ncardamone10/ELG4139/Project/topSidePop.png

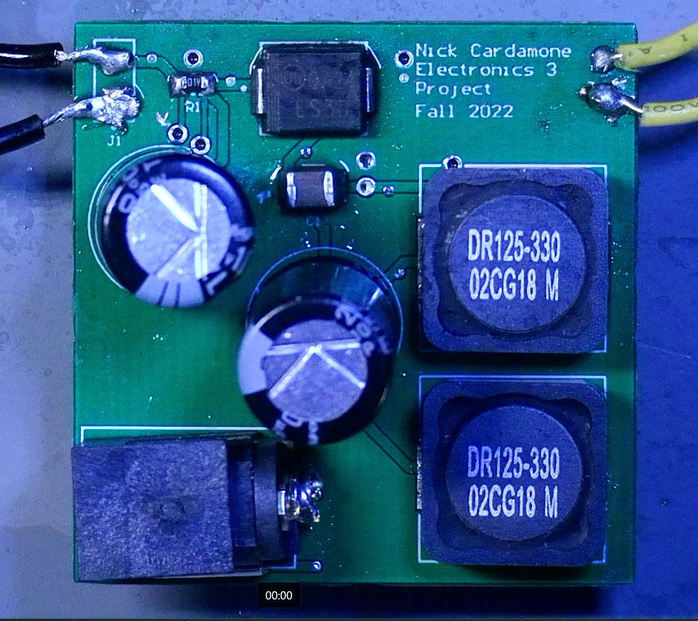
Project/topSidePop.png
