ncardamone10/ELG4139/Project/bottomSidePop.png

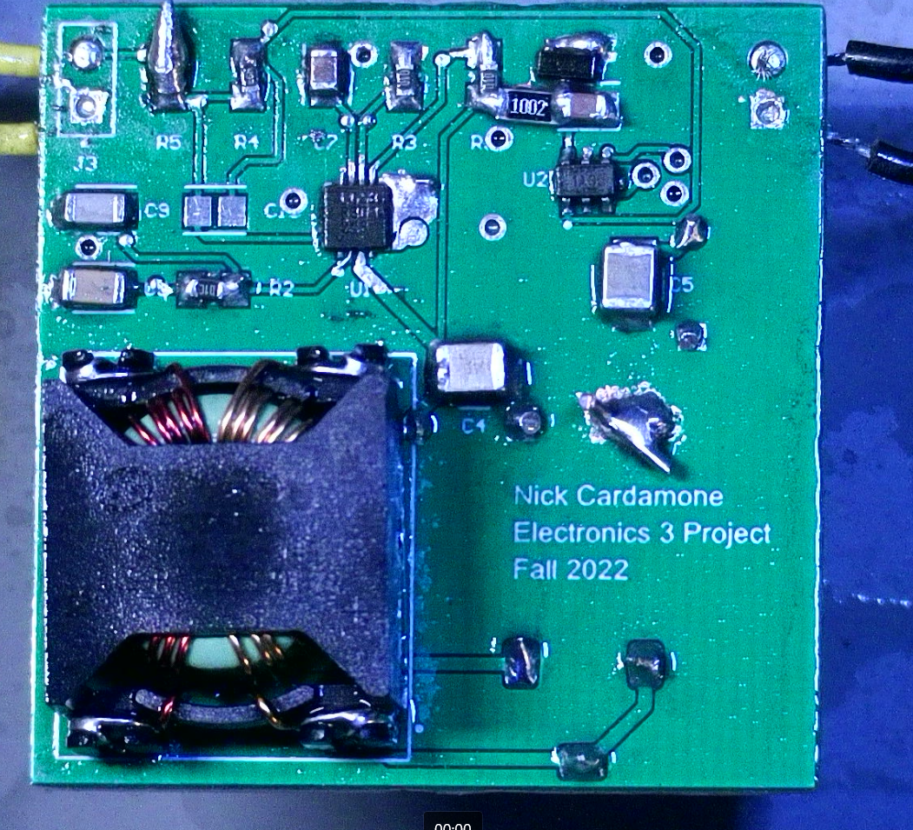
Project/bottomSidePop.png
