ncardamone10/ELG4139/Project/SEPIC Converter Final Lab Pres.pptx

## SEPIC Converter as A Constant Current LED Controller

Nick Cardamone – Electronics 3 – Nov 18 2022

## Background

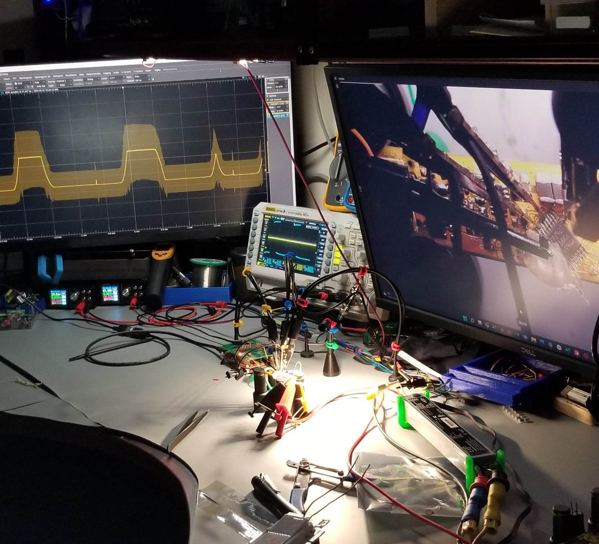
[picture p3: figure]
No description available.

- Did coop terms working at LED lighting company designing LED controllers
- Use scrap light engine for a desk lamp
- Currently use a bench supply to power the light engine

## Hardware Goals

Previous Prototype

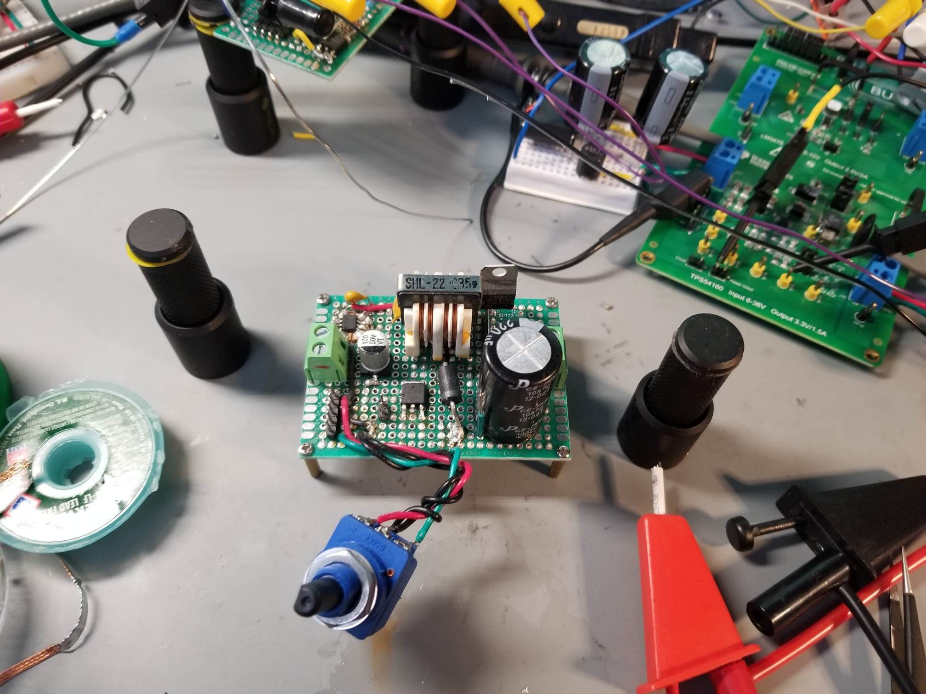
[picture p4: figure]
No description available.
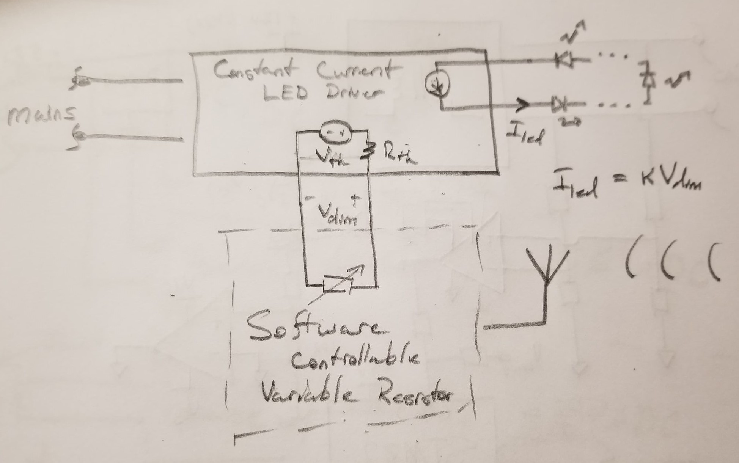
[picture p5: figure]

- I have a need for a contant current power supply (not a channel of a bench supply) to use to power my desk lamp

12V Wall Wart

Pot

No Bluetooth

## Presentation Overview

- Background and Motivation
- Problem Statement and Hardware Goals
- Circuit Diagram
- PCB Layout
- PCB 3D View
- Simulations
- Design Methodology
- Left TODO

## Circuit Diagram

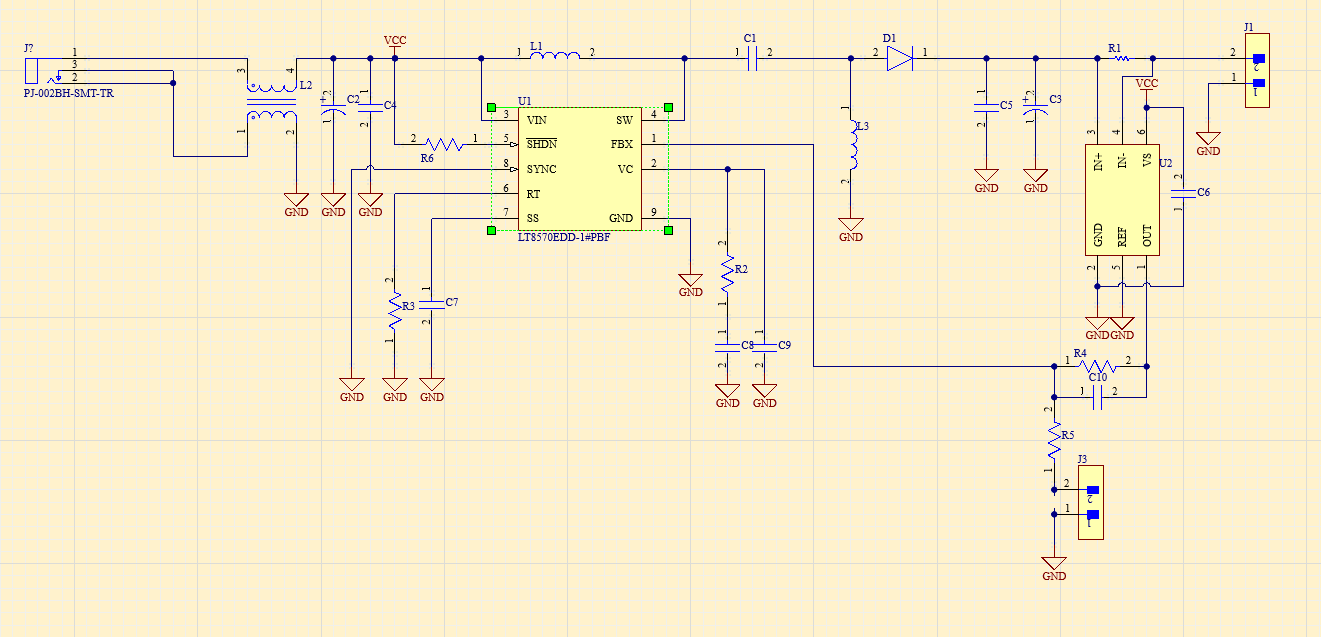
[picture p6: figure]
No description available.

- Sepic converter with current feedback

## Prototype

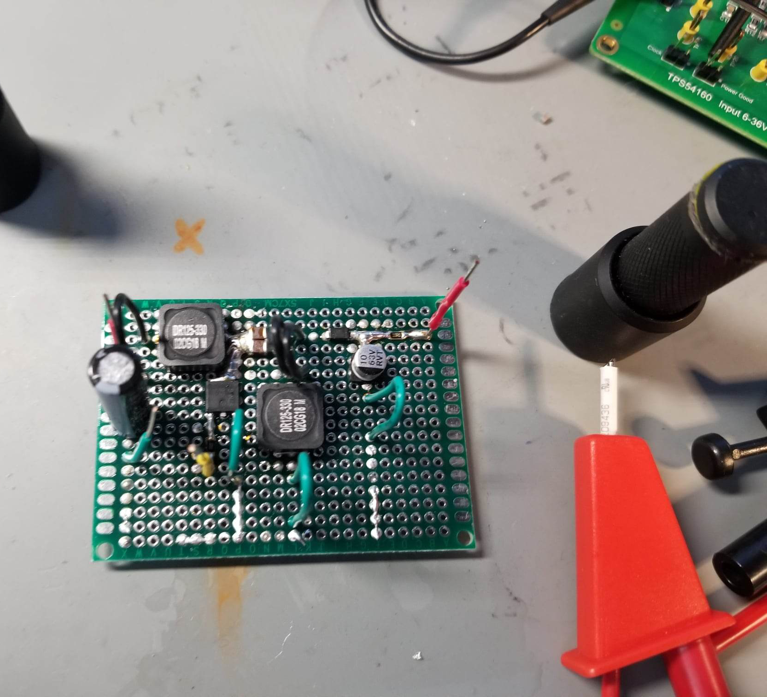
[picture p7: figure]
No description available.

- Open Loop Only

## PCB Layout

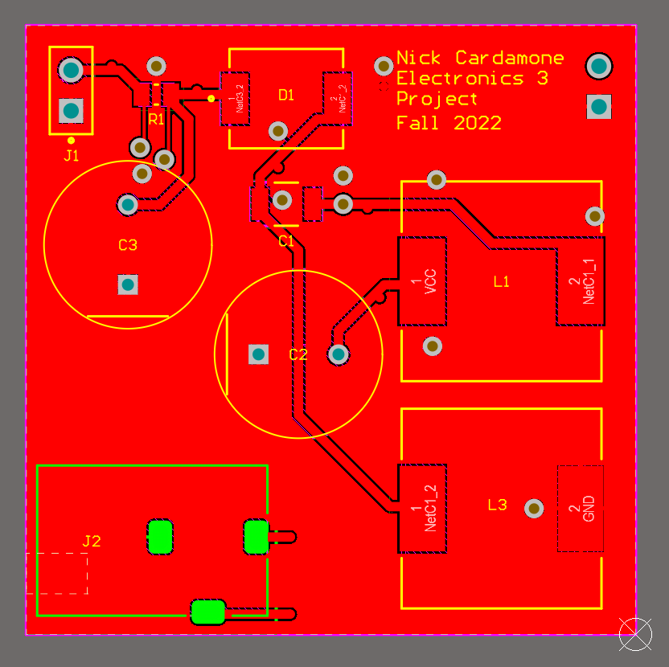
[picture p8: figure]
No description available.
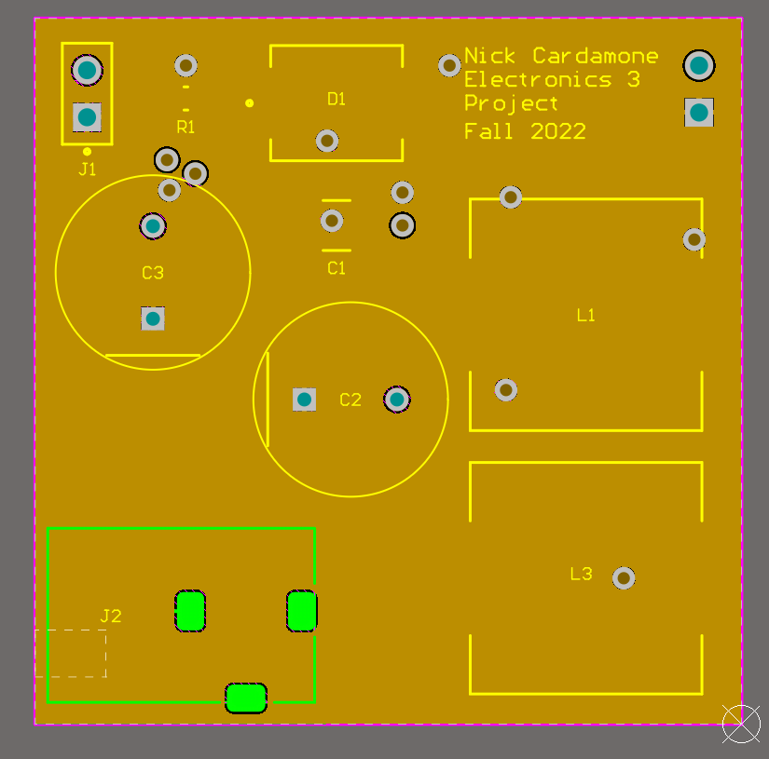
[picture p9: figure]
No description available.
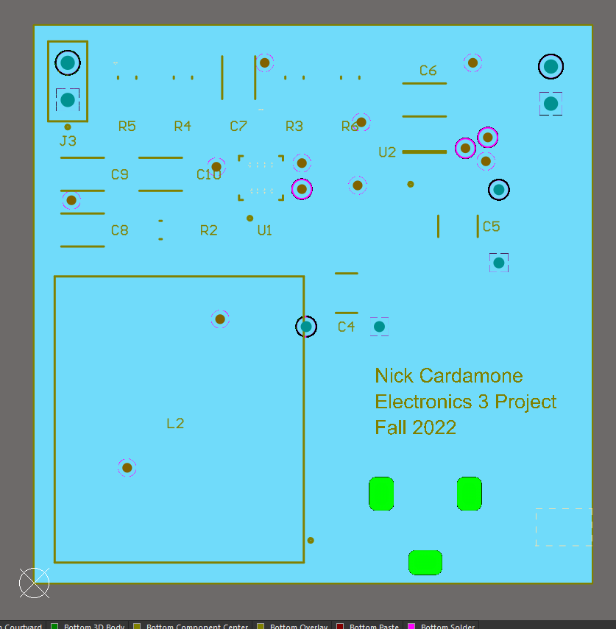
[picture p10: figure]
No description available.
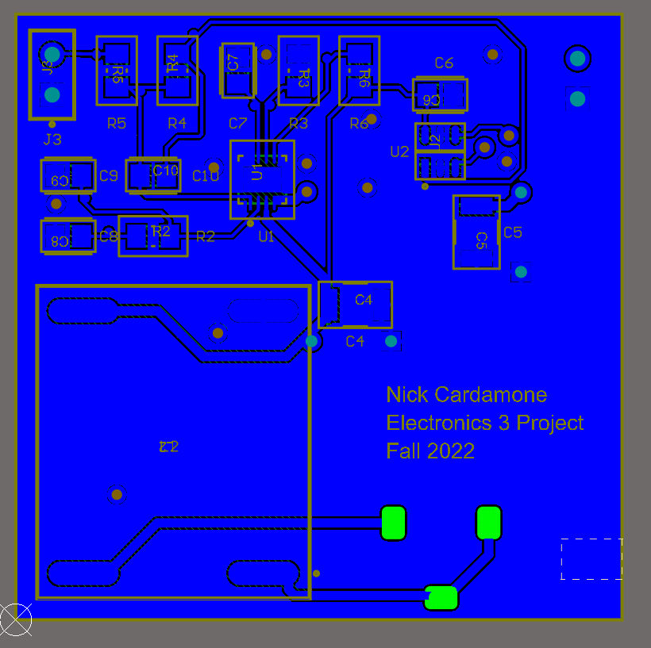
[picture p11: figure]
No description available.

- Layer Stack: Top, Gnd Plane, Gnd Plane, Bottom

## PCB

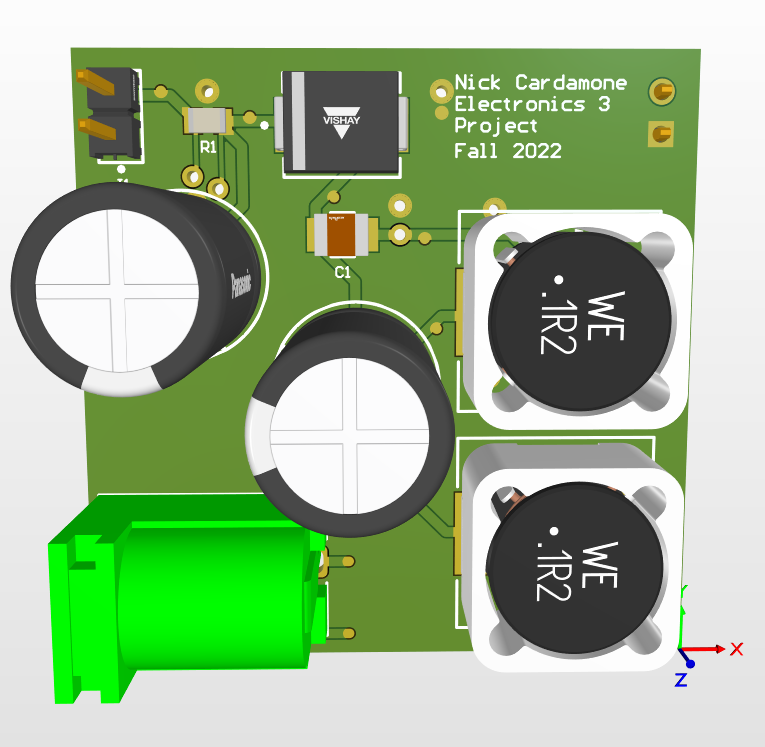
[picture p12: figure]
No description available.
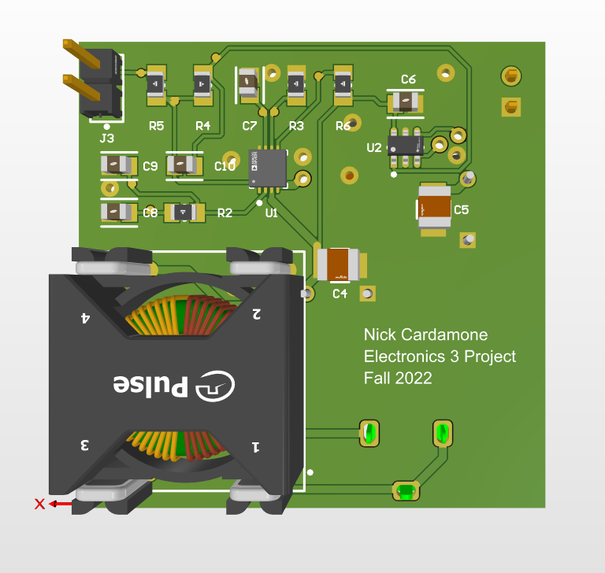
[picture p13: figure]
No description available.
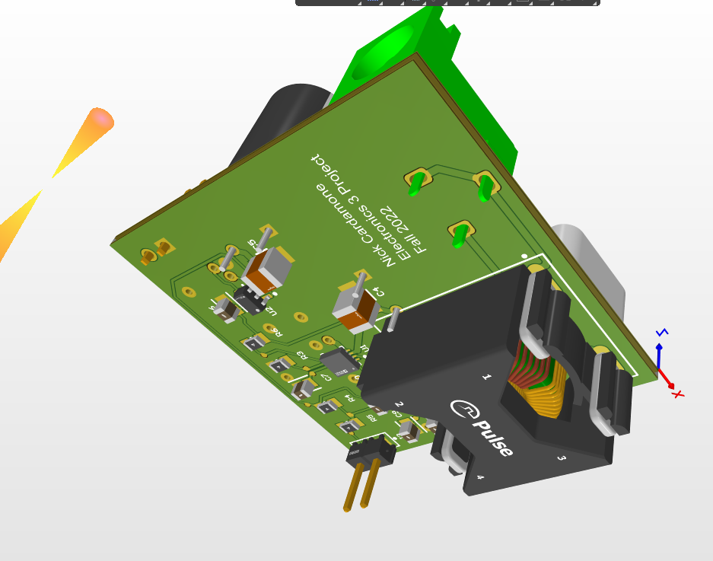
[picture p14: figure]
No description available.

## Simulations

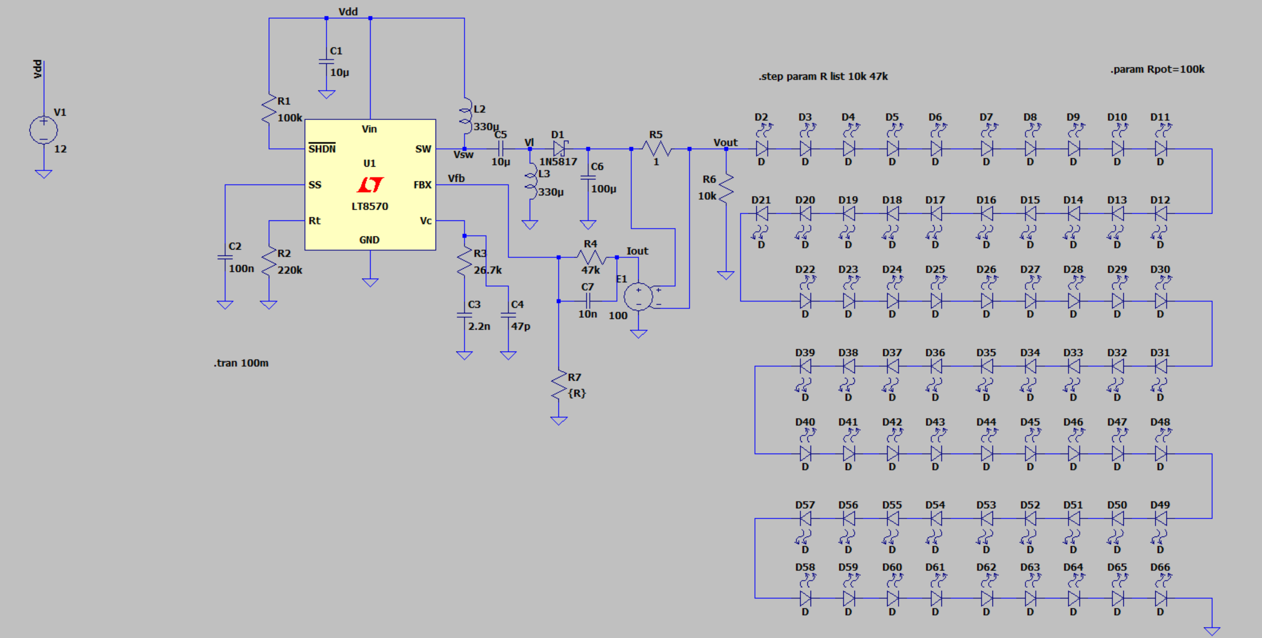
[picture p15: figure]
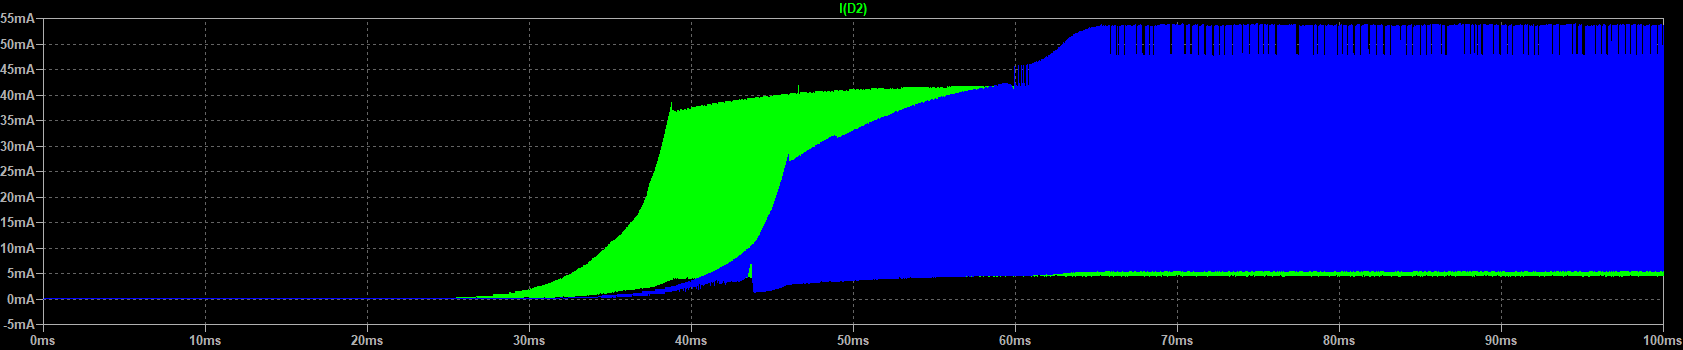
[picture p16: figure]

- Still large LED current ripple (called flicker in industry)
- Undesirable but not end of the world

## Thermals

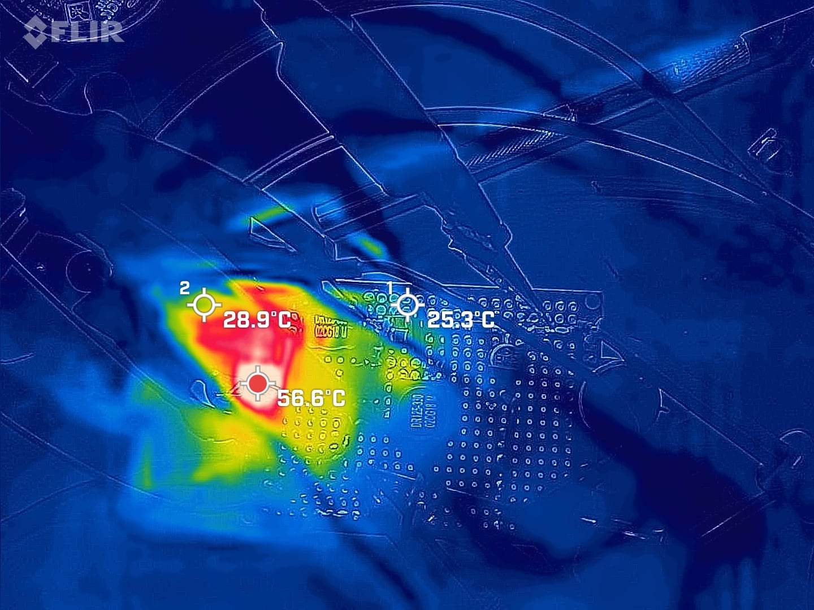
[picture p17: figure]
No description available.

- Max Temp: 56.6C (Input inductor on prototype)

## Design Steps

- Search through Digikey for SEPIC Converter IC
- Read datasheet
- Power Stage: convert design equations into code, brute force for component values
- Compensator
  - Bode plot of power stage transfer function
  - Bode plot of 1/feedback transfer function
  - Intersection needs closure of 20 dB/dec for 45 degrees of phase margin
  - RHPZ is a problem, put converter into DCM to eliminate problem
- Simulate circuit (LTSPICE) and iterate and refine component values

## Left todo

- PCBs arrive today/ there are on a truck now (ordered a week late because I had covid)
- Components need to be soldered on
- Component values need to be finalized
- Encasement needs to be made (probably out of Al, PCB submerged in oil for passive cooling)
- Simulate PCB with Ansys sim tool (sim tool doesn’t have good documentation that I can find)
- Characterize converter and generate plots for final report

## Design Module 1 PCBs

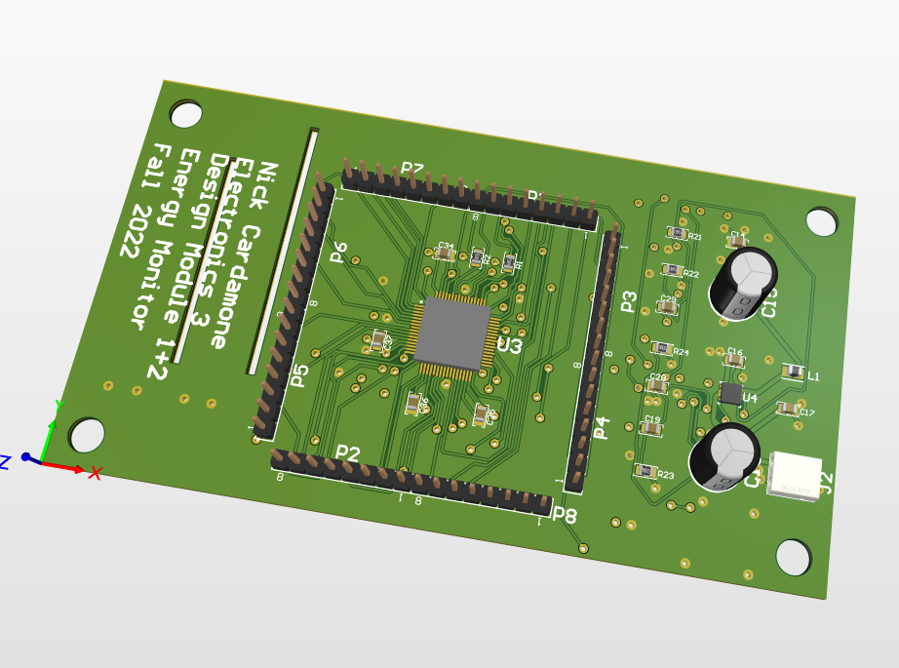
[picture p18: figure]
No description available.
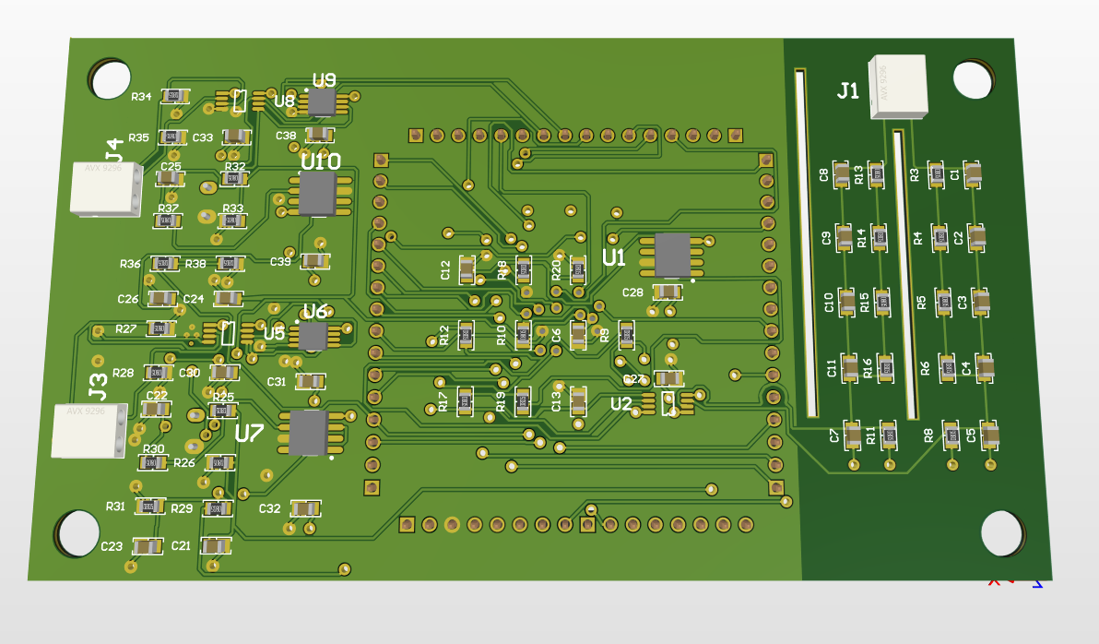
[picture p19: figure]
No description available.

- (why I was a week late ordering)
