ncardamone10/ELG4139/Project/bottomSide.png

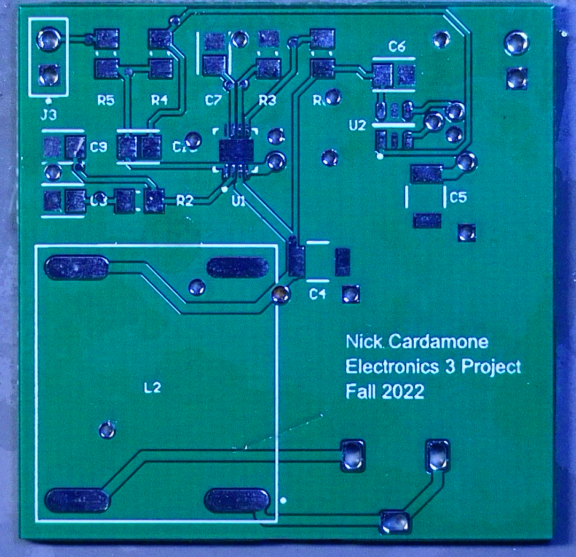
Project/bottomSide.png
