ncardamone10/ELG4139/Project/effVsResistor.png

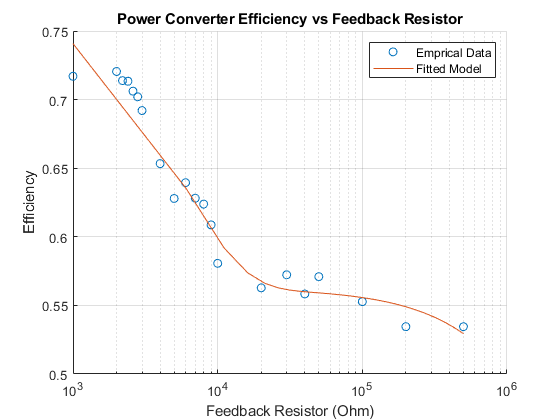
Project/effVsResistor.png
