ncardamone10/ELG4139/Project/simCircuit.png

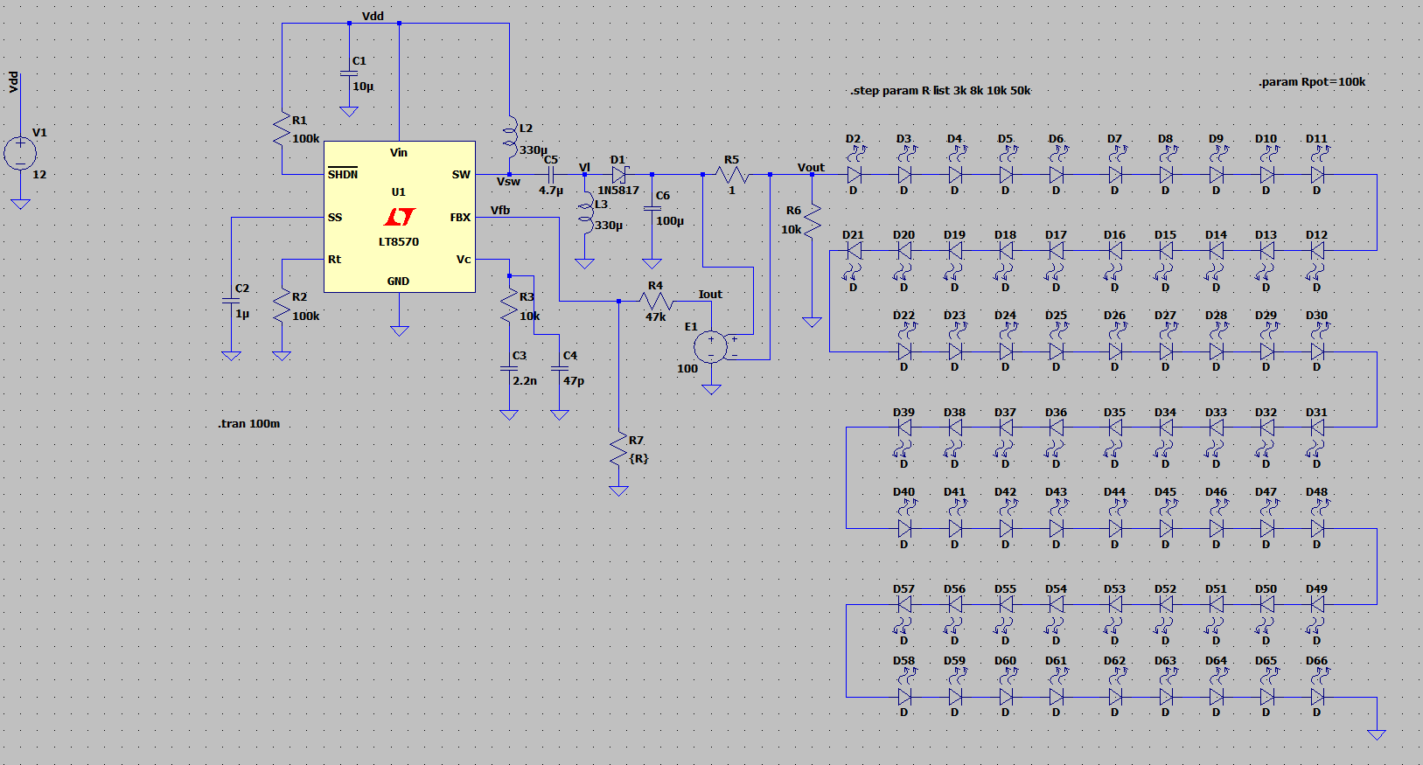
Project/simCircuit.png
