ncardamone10/ELG4139/Project/simPlot.png

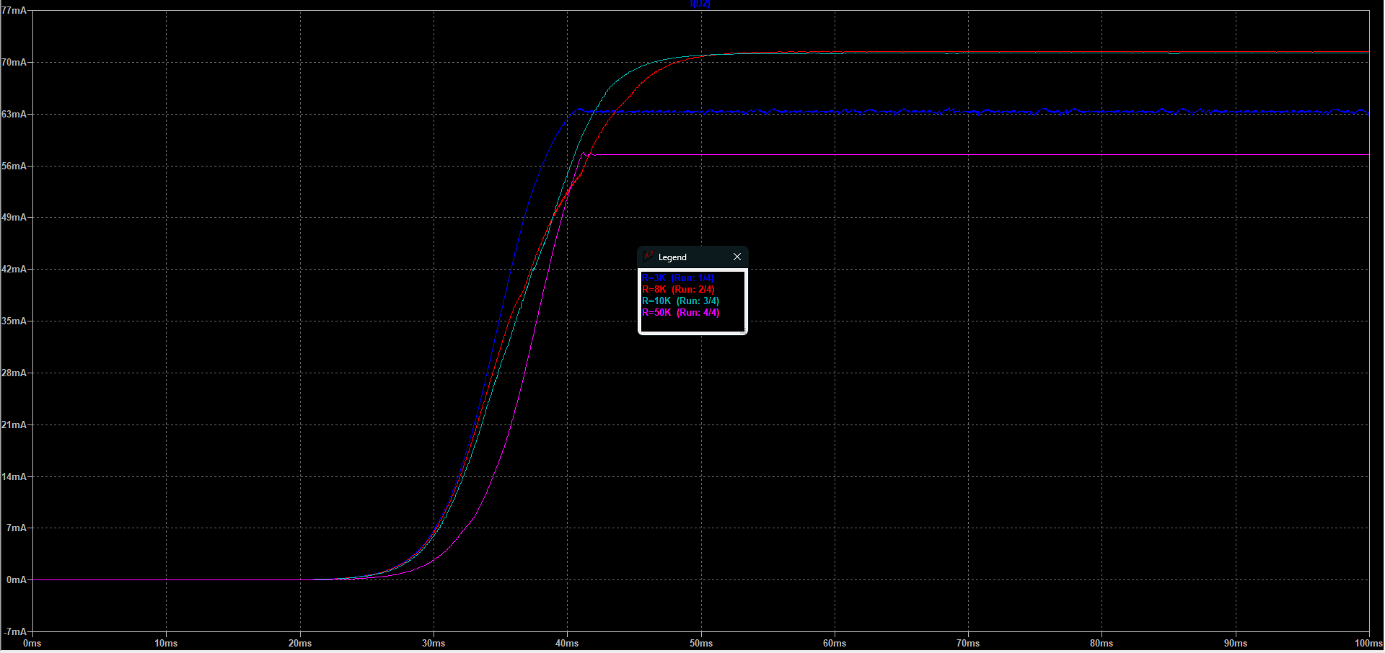
Project/simPlot.png
