ncardamone10/ELG4139/Project/topSide.png

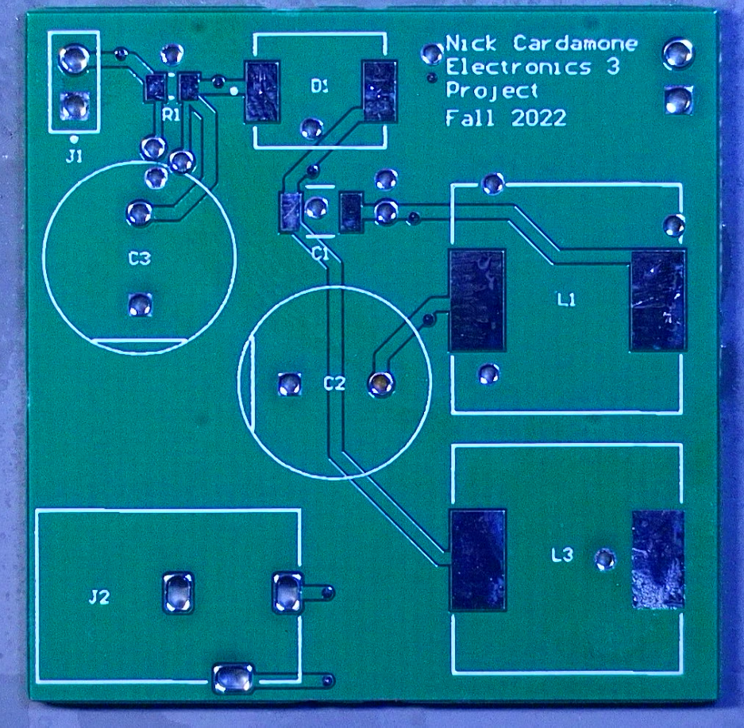
Project/topSide.png
