ncardamone10/ELG4139/Project/scopeScreenshots/DS1Z_QuickPrint14.png

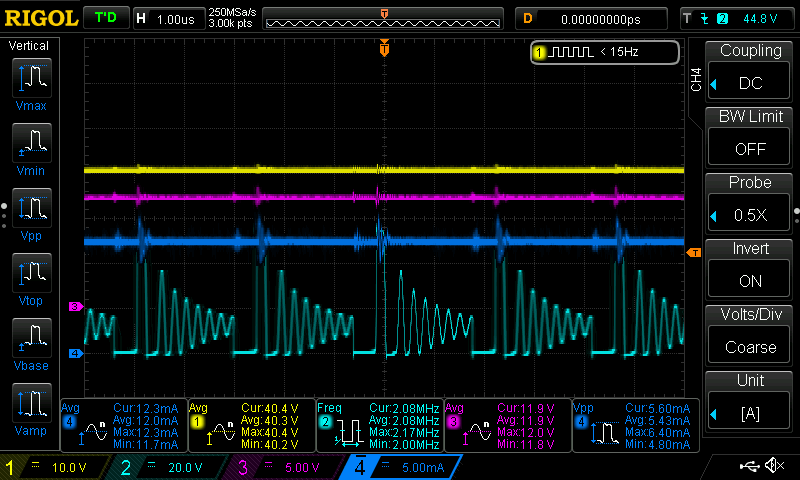
Project/scopeScreenshots/DS1Z_QuickPrint14.png
