ncardamone10/ELG4139/Project/scopeScreenshots/DS1Z_QuickPrint17.png

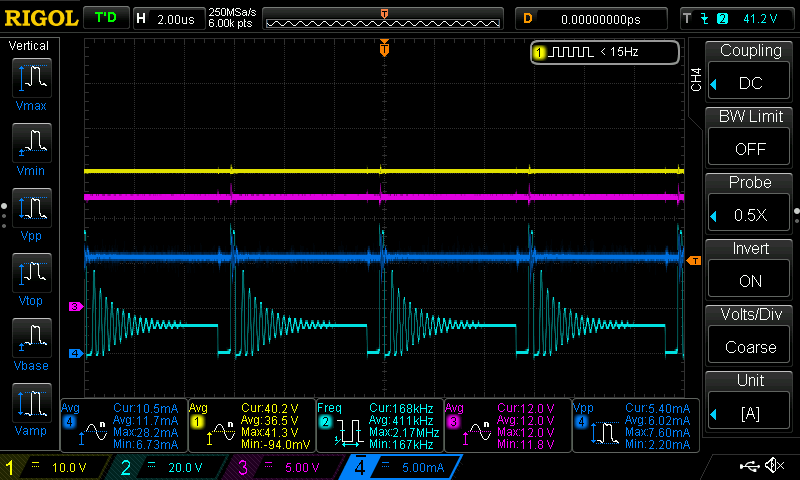
Project/scopeScreenshots/DS1Z_QuickPrint17.png
