ncardamone10/ELG4139/Project/Draft4.asc

C1: cap; 100µ
L1: ind; 10µ
L4: ind; 243µ
V1: voltage; ""; AC 1; Rser=1m
Named nets: 0
.ac dec 5000 1 10meg
