ncardamone10/ELG4139/Project/LT8570 with cc.asc

C1: cap; 10µ; Rser=1
C2: cap; 100n
C3: cap; 2.2n
C4: cap; 47p
C5: cap; 10µ; Rser=1
C6: cap; 100µ; Rser=1
C7: cap; 10n
D1: schottky; 1N5817
D2: LED
D3: LED
D4: LED
D5: LED
D6: LED
D7: LED
D8: LED
D9: LED
D10: LED
D11: LED
D12: LED
D13: LED
D14: LED
D15: LED
D16: LED
D17: LED
D18: LED
D19: LED
D20: LED
D21: LED
D22: LED
D23: LED
D24: LED
D25: LED
D26: LED
D27: LED
D28: LED
D29: LED
D30: LED
D31: LED
D32: LED
D33: LED
D34: LED
D35: LED
D36: LED
D37: LED
D38: LED
D39: LED
D40: LED
D41: LED
D42: LED
D43: LED
D44: LED
D45: LED
D46: LED
D47: LED
D48: LED
D49: LED
D50: LED
D51: LED
D52: LED
D53: LED
D54: LED
D55: LED
D56: LED
D57: LED
D58: LED
D59: LED
D60: LED
D61: LED
D62: LED
D63: LED
D64: LED
D65: LED
D66: LED
E1: e; 100
L2: ind; 330µ
L3: ind; 330µ; Rser=5
R1: res; 100k
R2: res; 220k
R3: res; 26.7k
R4: res; 47k
R5: res; 1
R6: res; 10k
R7: res; {R}
U1: LT8570
V1: voltage; 12
Named nets: 0, Vdd, Vsw, Vl, Vfb, Vout, Iout
.tran 100m
.step param R list 10k 47k
.param Rpot=100k
