ncardamone10/ELG4139/Project/LT8570.asc

C1: cap; 2.2µ
C2: cap; 100n
C3: cap; 2.2n
C4: cap; 47µ
C5: cap; 10µ
C6: cap; 2.2µ
D1: schottky; 1N5817
L2: ind; 1m
L3: ind; 1m; Rser=5
R1: res; 100k
R2: res; 121k
R3: res; 20.5k
R4: res; 490k
R5: res; 1k
U1: LT8570
Named nets: 0, Vdd
.tran 1
