ncardamone10/ELG4139/Project/SEPIC with controller.asc

C1: cap; 10µ
C2: cap; 100µ
C3: cap; 220n
C4: cap; 6.8n
C5: cap; 1µ
C6: cap; 100µ
D1: schottky; 1N5817
D2: LED; LUW-W5AP
D3: LED; LUW-W5AP
D4: LED; LUW-W5AP
D5: LED; LUW-W5AP
D6: LED; LUW-W5AP
D7: LED; LUW-W5AP
D8: LED; LUW-W5AP
D9: LED; LUW-W5AP
D10: LED; LUW-W5AP
D11: LED; LUW-W5AP
D12: LED; LUW-W5AP
D13: LED; LUW-W5AP
D14: LED; LUW-W5AP
D15: LED; LUW-W5AP
D16: LED; LUW-W5AP
L1: ind; 330µ; Rser=5
L2: ind; 330µ; Rser=5
R1: res; 100k
R2: res; 1k
R3: res; 10k
R7: res; 16.2k
R8: res; 121k
U1: LT8361
V1: voltage; 12
V2: voltage; 12
Named nets: 0, Vdd
.tran 1m
