ncardamone10/ELG4139/Project/SEPIC.asc

C1: cap; 1µ
C2: cap; 100µ
D1: schottky; 1N5817
D2: LED; LUW-W5AP
D3: LED; LUW-W5AP
D4: LED; LUW-W5AP
D5: LED; LUW-W5AP
D6: LED; LUW-W5AP
D7: LED; LUW-W5AP
D8: LED; LUW-W5AP
D9: LED; LUW-W5AP
D10: LED; LUW-W5AP
D11: LED; LUW-W5AP
D12: LED; LUW-W5AP
D13: LED; LUW-W5AP
D14: LED; LUW-W5AP
D15: LED; LUW-W5AP
D16: LED; LUW-W5AP
L1: ind; 150µ; Rser=10
L2: ind; 150µ; Rser=10
M1: nmos; BSC030N04NS
R1: res; 100k
V1: voltage; 10
V2: voltage; PULSE(0 10 1u 5n 5n {D*T} {T})
Named nets: 0
;.step param D list 0.2 0.4 0.6 0.8
.param T=1/50000
.tran 200m
.param D=0.5
