ncardamone10/ELG4139/(list of files, drawings)

Other design files:
Project/LED Controller/LED Controller.PrjPcb
Project/LED Controller/PCB1.PcbDoc
Project/LED Controller/PcbLib1.PcbLib
Project/LED Controller/Schlib1.SchLib
Project/LED Controller/Sheet1.SchDoc
